serialx/mini-esp32/mini-esp32.pdf

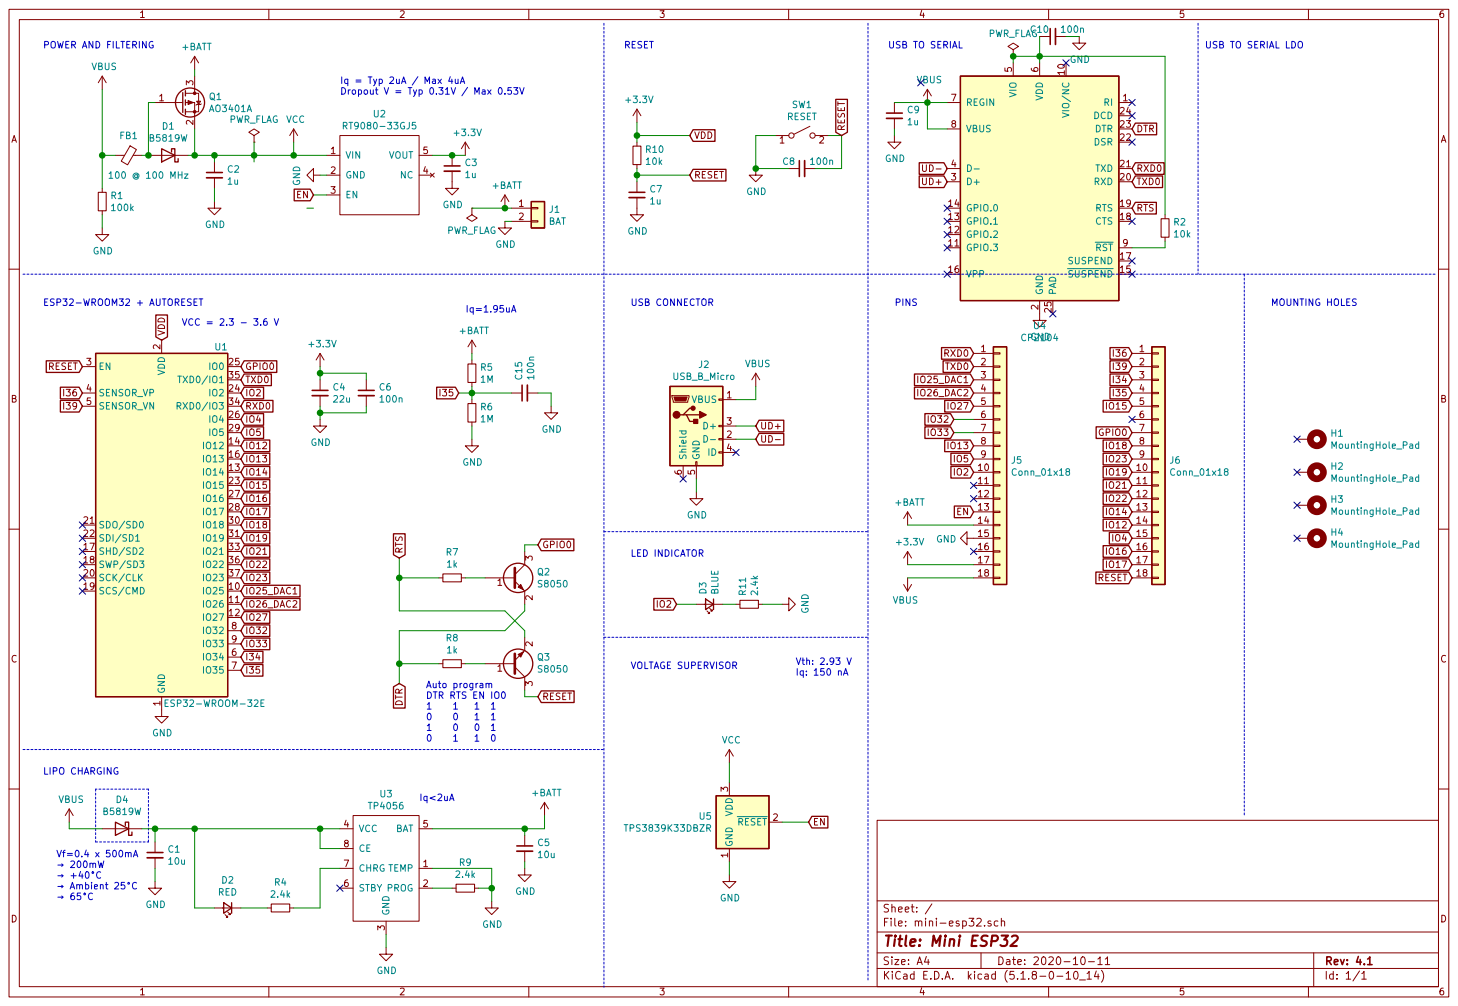
[picture p1: page 1]

USB TO SERIAL LDO

6 REGIN 7 VBUS 8 RST 9 U4 CP2104 VBUS

2 RXD 20 TXD 21 DSR 22 DTR 23 DCD 24 PAD 25 D+ 3 D- 4 VIO

2 SCK/CLK 20 SDO/SD0 21 SDI/SD1 22

3 VCC 4 BAT 5 STBY 6 CHRG 7 CE 8 U3 TP4056

File: mini-esp32.sch Sheet: /
Id: 1/1 Title: Mini ESP32
