serialx/mini-esp32/mini-esp32.kicad_pcb

## KiCad design mini-esp32.kicad_pcb (2020-12-13)

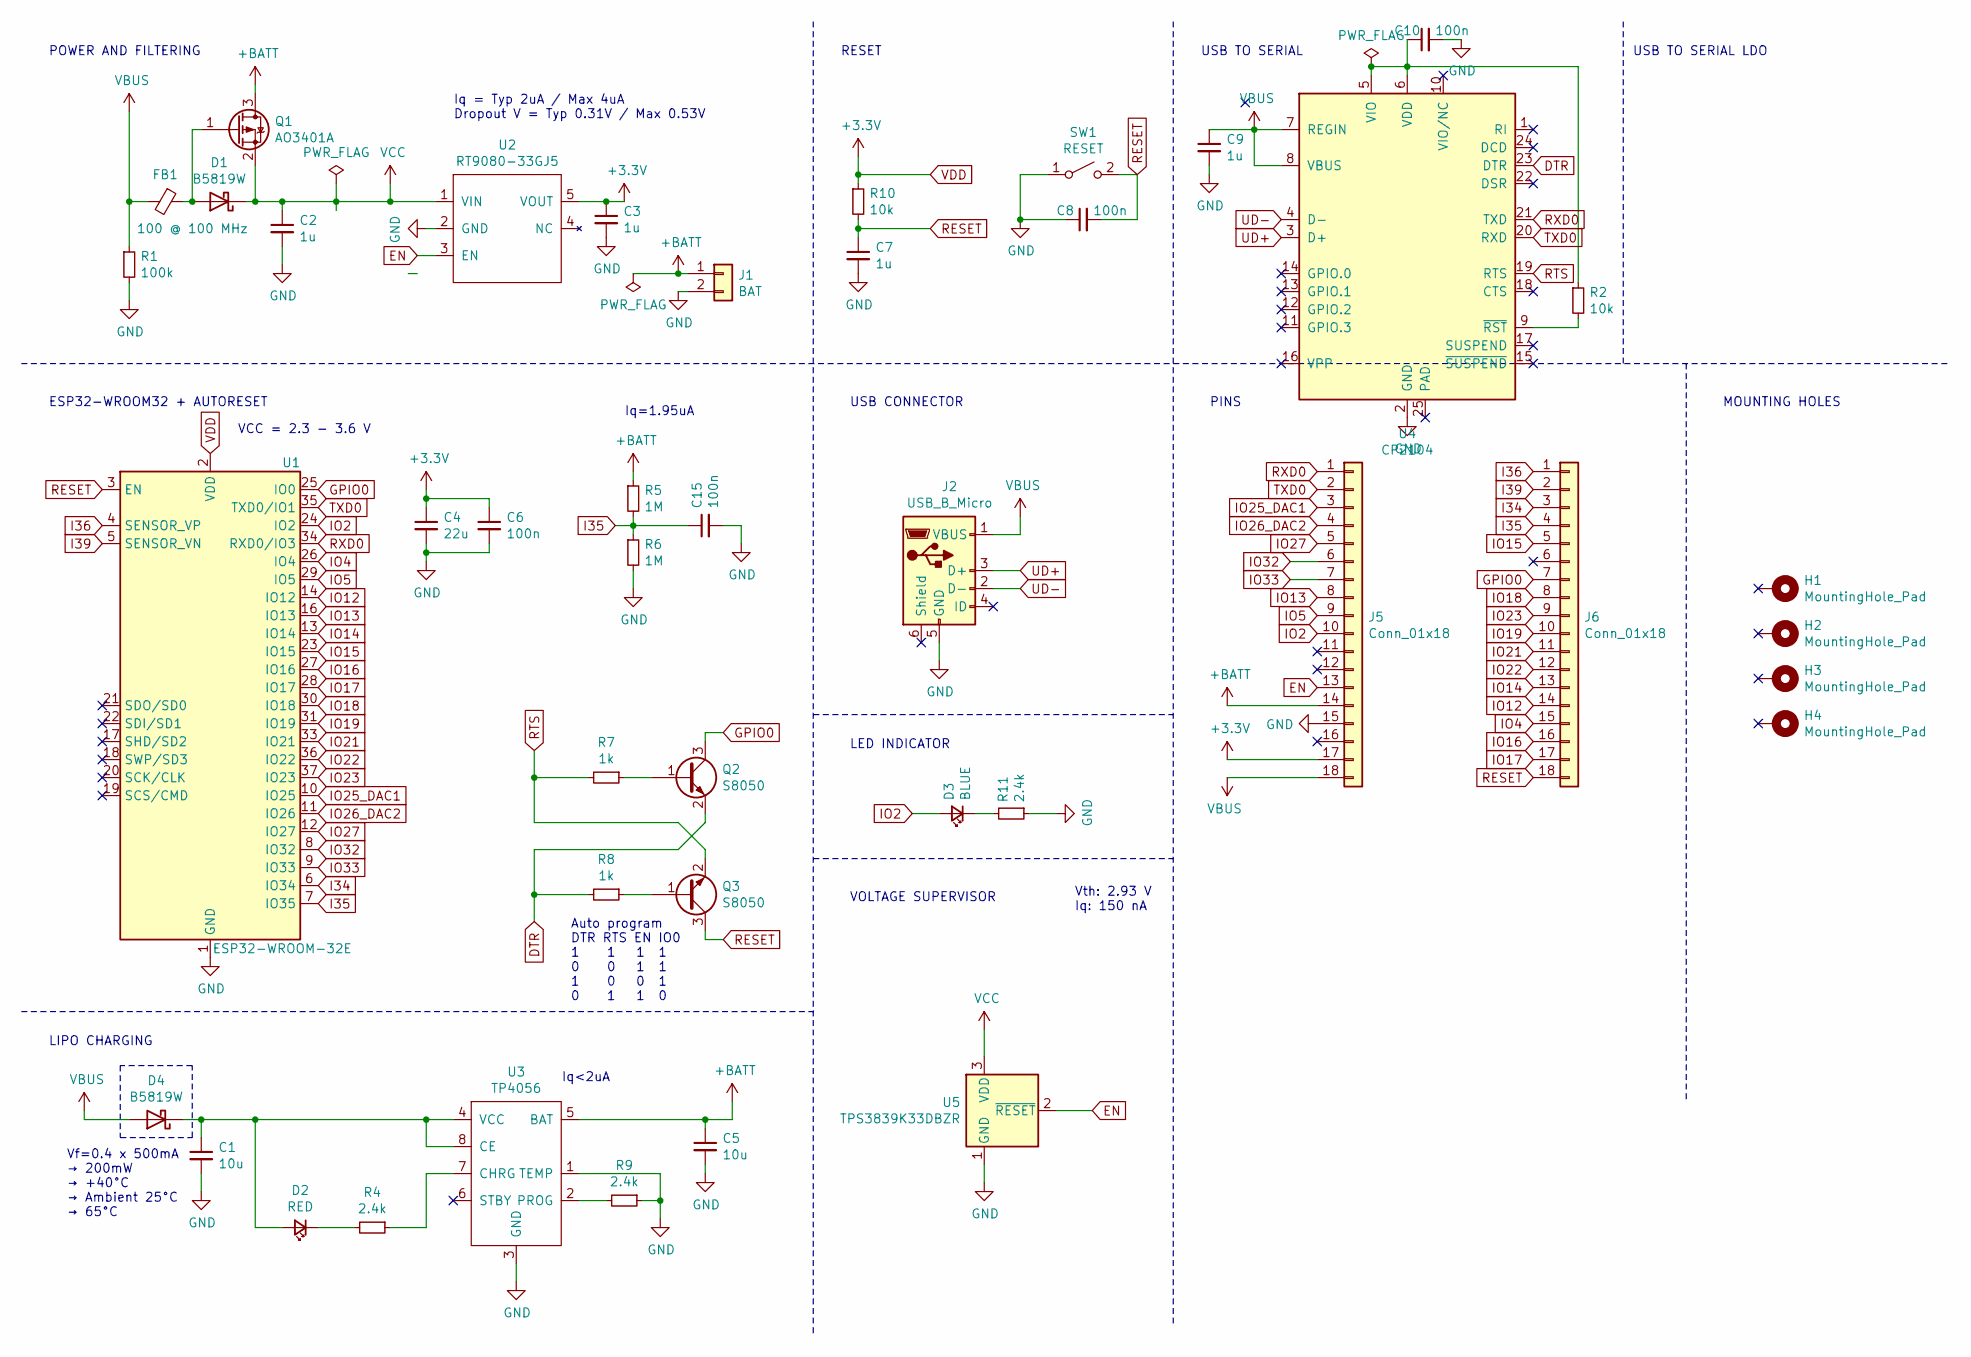
[picture p2: schematic mini-esp32.sch, Mini ESP32]

Parts:
C1, C5: 10u; C_0603_1608Metric; LCSC Part # C19702
C2, C3, C7, C9: 1u; C_0402_1005Metric; LCSC Part # C52923
C4: 22u; C_0603_1608Metric; LCSC Part # C59461
C6, C8, C10, C15: 100n; C_0402_1005Metric; LCSC Part # C1525
D1, D4: B5819W; D_SOD-123; LCSC Part # C8598
D2: RED; LED_0603_1608Metric; LCSC Part # C2286
D3: BLUE; LED_0603_1608Metric; LCSC Part # C72041
FB1: 100 @ 100 MHz; L_0805_2012Metric; LCSC Part # C1015
H1, H2, H3, H4: MountingHole_Pad; MountingHole_3mm
J1: BAT; JST_PH_B2B-PH-SM4-TB_1x02-1MP_P2.00mm_Vertical; LCSC Part # C146053
J2: USB_B_Micro; USB_Micro-B_Jing-C10418-A01SB141B1-067; LCSC Part # C10418
J5, J6: Conn_01x18; PinSocket_1x18_P2.54mm_Vertical
Q1: AO3401A; SOT-23; LCSC Part # C15127
Q2, Q3: S8050; SOT-23; LCSC Part # C2146
R1: 100k; R_0402_1005Metric; LCSC Part # C25741
R2, R10: 10k; R_0402_1005Metric; LCSC Part # C25744
R4, R9, R11: 2.4k; R_0603_1608Metric; LCSC Part # C22940
R5, R6: 1M; R_0402_1005Metric; LCSC Part # C26083
R7, R8: 1k; R_0402_1005Metric; LCSC Part # C11702
SW1: RESET; SW_SPST_TL3342; LCSC Part # C318887
U1: ESP32-WROOM-32E; ESP32-WROOM-32; LCSC Part # C701341
U2: RT9080-33GJ5; TSOT-23-5; LCSC Part # C841192
U3: TP4056; SOP-8_3.9x4.9mm_P1.27mm; LCSC Part # C16581
U4: CP2104; QFN-24-1EP_4x4mm_P0.5mm_EP2.6x2.6mm; LCSC Part # C47742
U5: TPS3839K33DBZR; SOT-23; LCSC Part # C96333

Connections:
+BATT: C5.1, J1.1, J5.14, Q1.3 (D), R5.1, U3.5 (BAT)
DTR: Q2.2 (E), R8.2, U4.23 (DTR)
EN: J5.13, U2.3 (EN), U5.2 (~RESET)
GND: C1.2, C2.2, C3.2, C4.2, C5.2, C6.2, C7.2, C8.1, C9.2, C10.2, C15.2, J1.2, J2.5 (GND), J5.15, R1.2, R6.2, R9.1, R11.1, SW1.1 (A), U1.1 (GND), U1.15 (GND), U1.38 (GND), U1.39 (GND), U2.2 (GND), U3.1 (TEMP), U3.3 (GND), U4.2 (GND), U5.1 (GND)
GPIO0: J6.7, Q2.3 (C), U1.25 (IO0)
I34: J6.3, U1.6 (IO34)
I35: C15.1, J6.4, R5.2, R6.1, U1.7 (IO35)
I36: J6.1, U1.4 (SENSOR_VP)
I39: J6.2, U1.5 (SENSOR_VN)
IO2: D3.2 (A), J5.10, U1.24 (IO2)
IO4: J6.15, U1.26 (IO4)
IO5: J5.9, U1.29 (IO5)
IO12: J6.14, U1.14 (IO12)
IO13: J5.8, U1.16 (IO13)
IO14: J6.13, U1.13 (IO14)
IO15: J6.5, U1.23 (IO15)
IO16: J6.16, U1.27 (IO16)
IO17: J6.17, U1.28 (IO17)
IO18: J6.8, U1.30 (IO18)
IO19: J6.10, U1.31 (IO19)
IO21: J6.11, U1.33 (IO21)
IO22: J6.12, U1.36 (IO22)
IO23: J6.9, U1.37 (IO23)
IO25_DAC1: J5.3, U1.10 (IO25)
IO26_DAC2: J5.4, U1.11 (IO26)
IO27: J5.5, U1.12 (IO27)
IO32: J5.6, U1.8 (IO32)
IO33: J5.7, U1.9 (IO33)
unnamed: C1.1, D2.2 (A), D4.1 (K), U3.4 (VCC), U3.8 (CE)
unnamed: C10.1, R2.1, U4.5 (VIO), U4.6 (VDD)
unnamed: D1.2 (A), FB1.1, Q1.1 (G)
unnamed: D2.1 (K), R4.2
unnamed: D3.1 (K), R11.2
unnamed: Q2.1 (B), R7.1
unnamed: Q3.1 (B), R8.1
unnamed: R2.2, U4.9 (~RST)
unnamed: R4.1, U3.7 (CHRG)
unnamed: R9.2, U3.2 (PROG)
RESET: C7.1, C8.2, J6.18, Q3.3 (C), R10.2, SW1.2 (B), U1.3 (EN)
RTS: Q3.2 (E), R7.2, U4.19 (RTS)
RXD0: J5.1, U1.34 (RXD0/IO3), U4.21 (TXD)
TXD0: J5.2, U1.35 (TXD0/IO1), U4.20 (RXD)
UD+: J2.3 (D+), U4.3 (D+)
UD-: J2.2 (D-), U4.4 (D-)
VBUS: C9.1, D4.2 (A), FB1.2, J2.1 (VBUS), J5.18, R1.1, U4.7 (REGIN), U4.8 (VBUS)
VCC: C2.1, D1.1 (K), Q1.2 (S), U2.1 (VIN), U5.3 (VDD)
VDD: C3.1, C4.1, C6.1, J5.17, R10.1, U1.2 (VDD), U2.5 (VOUT)

Notes on the sheet:
POWER AND FILTERING
RESET
USB TO SERIAL
ESP32-WROOM32 + AUTORESET
LIPO CHARGING
LED INDICATOR
MOUNTING HOLES
PINS
USB CONNECTOR
VOLTAGE SUPERVISOR
Vf=0.4 x 500mA → 200mW → +40°C → Ambient 25°C → 65°C
Vth: 2.93 V Iq: 150 nA
Iq<2uA
Iq=1.95uA
USB TO SERIAL LDO
Iq = Typ 2uA / Max 4uA Dropout V = Typ 0.31V / Max 0.53V
VCC = 2.3 - 3.6 V
Auto program DTR RTS EN IO0 1 1 1 1 0 0 1 1 1 0 0 1 0 1 1 0

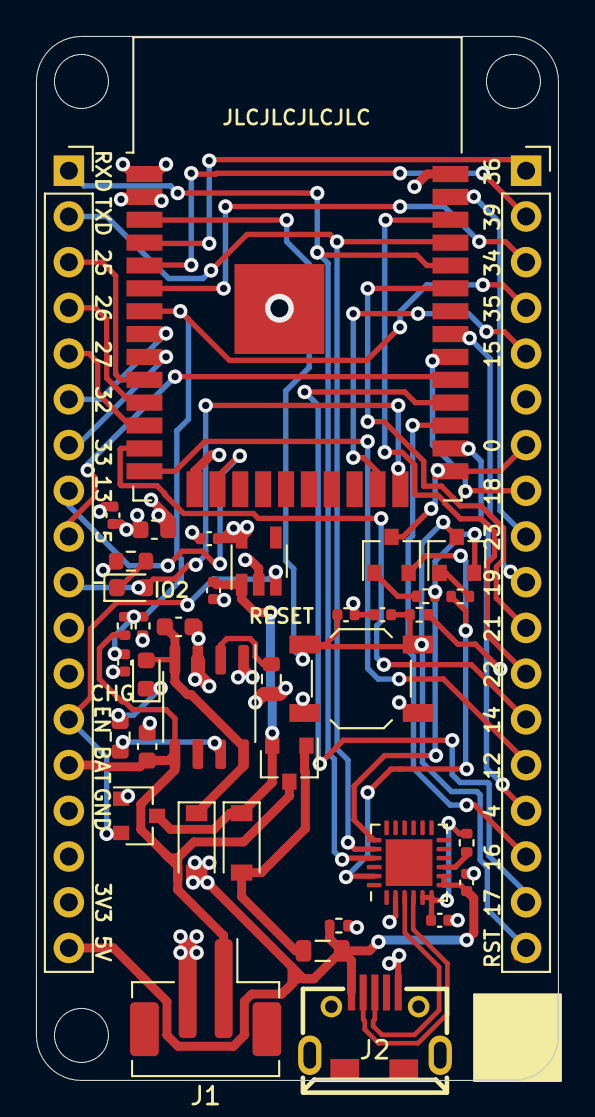
[picture p3: board mini-esp32.kicad_pcb from above]

Board: 4 copper layers, 29.0 x 58.0 mm, 43 parts (0 on the bottom side), 47 nets.
