serialx/mini-esp32/(commit log)

2020-11-01 Initial commit. v2.0
    [esp32-dev-B_Cu.gbr, esp32-dev-B_Mask.gbr, esp32-dev-B_Paste.gbr, esp32-dev-B_SilkS.gbr, esp32-dev-Edge_Cuts.gbr, esp32-dev-F_Cu.gbr, esp32-dev-F_Mask.gbr, esp32-dev-F_Paste.gbr]
2020-11-01 Rename files
    [mini-esp32-B_Cu.gbr, mini-esp32-B_Mask.gbr, mini-esp32-B_Paste.gbr, mini-esp32-B_SilkS.gbr, mini-esp32-Edge_Cuts.gbr, mini-esp32-F_Cu.gbr, mini-esp32-F_Mask.gbr, mini-esp32-F_Paste.gbr]
2020-11-01 Fix power/gnd planes in the antenna zone.
    [mini-esp32-B_Cu.gbr, mini-esp32-B_Mask.gbr, mini-esp32-B_Paste.gbr, mini-esp32-B_SilkS.gbr, mini-esp32-Edge_Cuts.gbr, mini-esp32-F_Cu.gbr, mini-esp32-F_Mask.gbr, mini-esp32-F_Paste.gbr]
2020-11-02 Fix USB Micro B footprint to official one
    [mini-esp32.kicad_pcb, mini-esp32.sch]
2020-11-02 Pad courtyard adjustment. ESP32 GND pad larger hole. Etc. V2.0.1
    [mini-esp32-B_Cu.gbr, mini-esp32-B_Mask.gbr, mini-esp32-B_Paste.gbr, mini-esp32-B_SilkS.gbr, mini-esp32-Edge_Cuts.gbr, mini-esp32-F_Cu.gbr, mini-esp32-F_Mask.gbr, mini-esp32-F_Paste.gbr]
2020-11-04 Improved routing. Internal layers are not used anymore for routing.
    [mini-esp32.kicad_pcb, mini-esp32.sch]
2020-11-04 Gerber output. V2.0.2
    [mini-esp32-B_Cu.gbr, mini-esp32-B_Mask.gbr, mini-esp32-B_Paste.gbr, mini-esp32-B_SilkS.gbr, mini-esp32-Edge_Cuts.gbr, mini-esp32-F_Cu.gbr, mini-esp32-F_Mask.gbr, mini-esp32-F_Paste.gbr]
2020-11-04 Add FS312F-G battery protection IC
    [mini-esp32.kicad_pcb, mini-esp32.sch]
2020-11-05 Polishing. V2.1.0
    [mini-esp32-B_Cu.gbr, mini-esp32-B_Mask.gbr, mini-esp32-B_Paste.gbr, mini-esp32-B_SilkS.gbr, mini-esp32-Edge_Cuts.gbr, mini-esp32-F_Cu.gbr, mini-esp32-F_Mask.gbr, mini-esp32-F_Paste.gbr]
2020-11-13 Fix three critical bugs
    1. Fix RXD TXD wiring
    2. Fix LDO EN pin resistor
    3. Fix programming not working (DTR RTS programming transistor resistor values)
    [mini-esp32-B_Cu.gbr, mini-esp32-B_Mask.gbr, mini-esp32-B_Paste.gbr, mini-esp32-B_SilkS.gbr, mini-esp32-Edge_Cuts.gbr, mini-esp32-F_Cu.gbr, mini-esp32-F_Mask.gbr, mini-esp32-F_Paste.gbr]
2020-11-14 Fix more critical bugs
    Fix NPN transistor pin mapping.
    Re-add LDO EN pin pull up resistor.
    Fix battery protection IC wiring and components to recommendation.
    [mini-esp32-B_Cu.gbr, mini-esp32-B_Mask.gbr, mini-esp32-B_Paste.gbr, mini-esp32-B_SilkS.gbr, mini-esp32-Edge_Cuts.gbr, mini-esp32-F_Cu.gbr, mini-esp32-F_Mask.gbr, mini-esp32-F_Paste.gbr]
2020-11-17 Fix CH340G. Backside pin numbering.
    - Crystal cap to 22pF from 33pf like the reference implementation.
    - Fix CH340G VCC to use an extra LDO instead of using RT9080 with a N MOSFET. N MOSFET to the GND seems to interfere with the CH340G's USB signalling.
    - Backside silkscreen pin numbering
    [mini-esp32-B_Cu.gbr, mini-esp32-B_Mask.gbr, mini-esp32-B_Paste.gbr, mini-esp32-B_SilkS.gbr, mini-esp32-Edge_Cuts.gbr, mini-esp32-F_Cu.gbr, mini-esp32-F_Mask.gbr, mini-esp32-F_Paste.gbr]
2020-11-17 Change 0.1R TP4056 resistor to a diode
    Helps with the heat issues of TP4056.
    [mini-esp32.kicad_pcb, mini-esp32.sch]
2020-11-17 Extra GND heat dissipation for TP4056
    [mini-esp32.kicad_pcb]
2020-11-17 Add comments in the schematic
    [mini-esp32.sch]
2020-11-17 Lower leakage current on battery voltage divider. Add caps.
    [mini-esp32.kicad_pcb, mini-esp32.sch]
2020-11-17 Fix EN pin cap to increase startup delay. Cheaper main bulk cap.
    Improve thermals for D4 diode. (For charging)
    [mini-esp32.kicad_pcb, mini-esp32.sch]
2020-11-17 Inspection. Tuning. Gerber & assembly files.
    [mini-esp32-B_Cu.gbr, mini-esp32-B_Mask.gbr, mini-esp32-B_Paste.gbr, mini-esp32-B_SilkS.gbr, mini-esp32-Edge_Cuts.gbr, mini-esp32-F_Cu.gbr, mini-esp32-F_Mask.gbr, mini-esp32-F_Paste.gbr]
2020-11-21 Add notes for auto programming circuit
    [mini-esp32.sch]
2020-11-25 Use TPS3839 instead of battery OC/OD. Lower power usage.
    [mini-esp32.kicad_pcb, mini-esp32.sch]
2020-11-25 Gerber and assembly for 4.0
    [mini-esp32-B_Cu.gbr, mini-esp32-B_Mask.gbr, mini-esp32-B_Paste.gbr, mini-esp32-B_SilkS.gbr, mini-esp32-Edge_Cuts.gbr, mini-esp32-F_Cu.gbr, mini-esp32-F_Mask.gbr, mini-esp32-F_Paste.gbr]
2020-11-25 Missing commit
    [mini-esp32.kicad_pcb]
2020-12-13 Change USB-to-Serial to CP2104
    [mini-esp32-B_Cu.gbr, mini-esp32-B_Mask.gbr, mini-esp32-B_Paste.gbr, mini-esp32-B_SilkS.gbr, mini-esp32-Edge_Cuts.gbr, mini-esp32-F_Cu.gbr, mini-esp32-F_Mask.gbr, mini-esp32-F_Paste.gbr]
